tedlanghorst/OpenOBS/hardware/EquipmentList.md

The equipment below is the *minimum* required equipment to construct an OpenOBS. We don't recommend specific brands/items, but the costs represent a cheap but reasonably quality version of each item. Prices were researched for purchase in North Carolina, USA, and may vary based on location.

| Item | Cost |
| --- | --- |
| Soldering station | $50 |
| Multimeter | $10 |
| Wire strippers | $5 |
| Flush cutters | $8 |
| 3D printer | $200 |
| Hot glue gun | $10 |
| Pipe cutter | $20 |
| | |
| | |
| | **Total** |
| | $298 |
