tedlanghorst/OpenOBS/documentation/images/interface.PNG

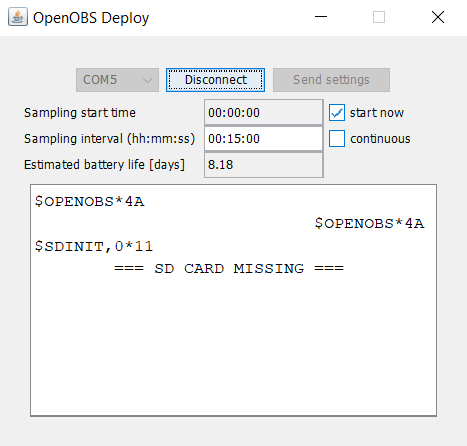
documentation/images/interface.PNG
