tedlanghorst/OpenOBS/hardware/PCB_gerber/schematic_rev2.png

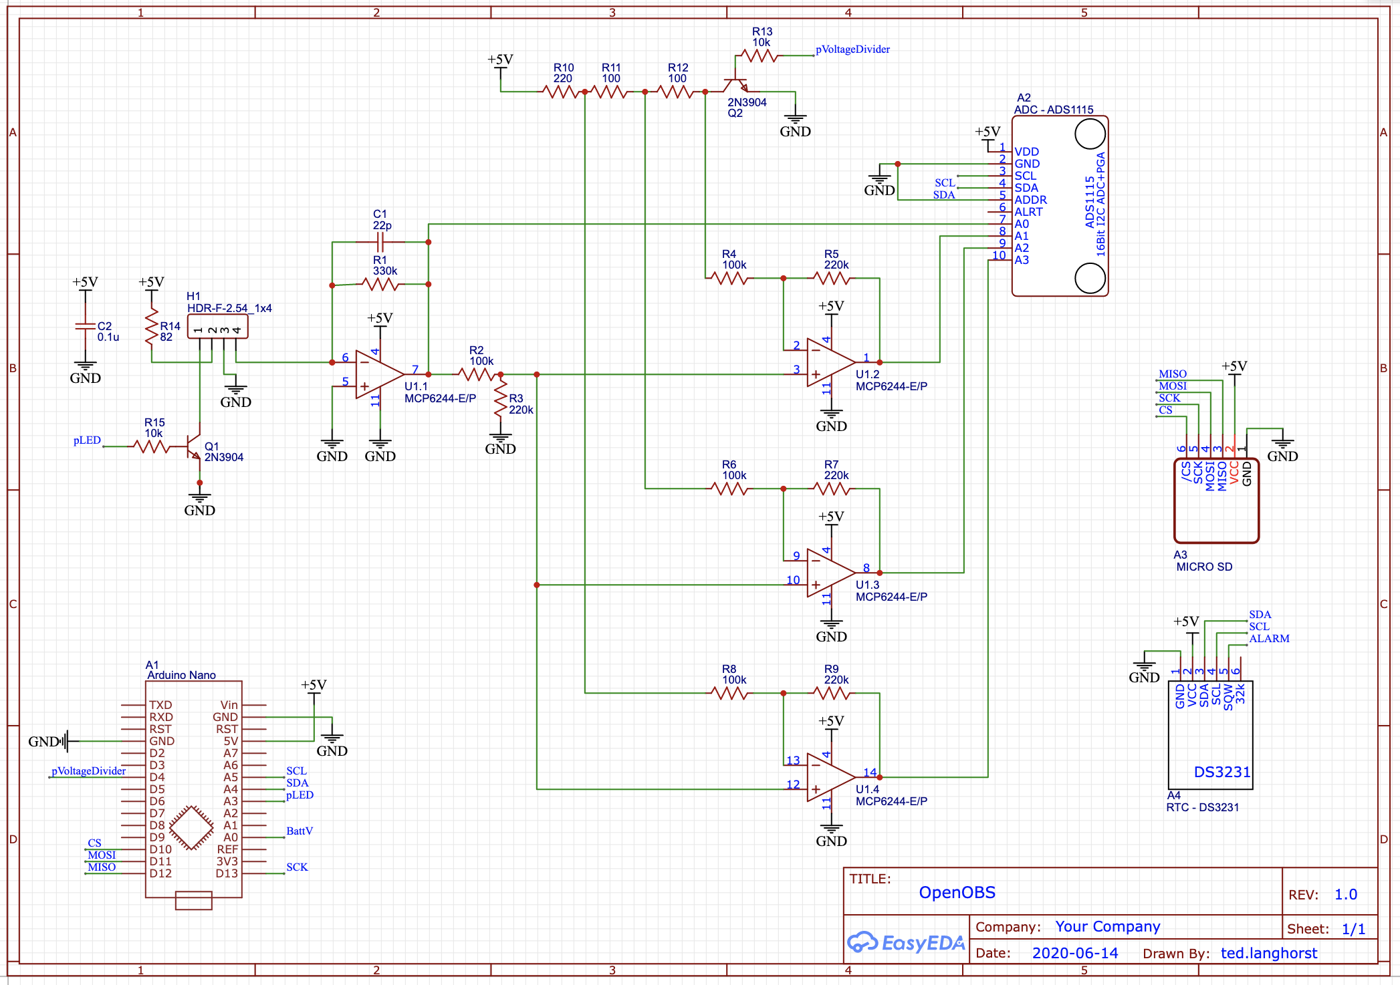
hardware/PCB_gerber/schematic_rev2.png
