tedlanghorst/OpenOBS/hardware/PartsList.md

| Part | Specific Part ID | Unit Cost | Quantity | Total Cost |
| --- | --- | --- | --- | --- |
| Arduino Nano | ATmega328P | $4.50 | 1 | $4.50 |
| ADC module | ADS1115 | $4.00 | 1 | $4.00 |
| microSD card module | | $1.90 | 1 | $1.90 |
| microSD card | | $7.00 | 1 | $7.00 |
| RTC module | DS3231 | $2.20 | 1 | $2.20 |
| RTC coin battery | CR2032 | | 1 | |
| Battery clip | | $1.50 | 1 | $1.50 |
| AA Battery | Any 1.2-1.6V nominal AA battery. | | 2 | |
| NIR emitting diode | VSMF4720-GS08 | $0.82 | 1 | $0.82 |
| NIR emitting diode alternative| SIR67-21C/TR8 | 0.64 | 1 | 0.64 |
| NIR photodiode | SFH 235 FA | $1.34 | 1 | $1.34 |
| Op amp | MCP6244 | $0.63 | 1 | $0.63 |
| MOSFET battery switch | SI2329DS-T1-GE3 | $0.62 | 1 | $0.62 |
| MOSFET battery switch alternative| SSSM3J56MFV,L3F | $0.47 | 1 | $0.47 |
| 0.1  μF capacitor | generic ceramic disc | $0.24 | 1 | $0.24 |
| 22 pF capacitor | generic cermaic disc | $0.24 | 1 | $0.24 |
| NPN transistor | 2n3904 | $0.05 | 2 | $0.10 |
| protoboard | generic 0.1" pitch | $0.20 | 1 | $0.20 |
| Printed circuit board (PCB) | [custom](/hardware/PCB_gerber) | $1.05 | 1 | $1.05 |
| Copper wire | generic 24 gauge | $0.50 | | |
| Solder | | $0.20 | | |
| Hot glue | | $0.20 | | |
| 82 Ω resistor | **1/2 W** or greater | $0.05 | 1 | $0.05 |
| 100 Ω resistor | | $0.05 | 2 | $0.10 |
| 220 Ω resistor | | $0.05 | 1 | $0.05 |
| 10k Ω resistor | | $0.05 | 2 | $0.10 |
| 100k Ω resistor | | $0.05 | 4 | $0.20 |
| 220k Ω resistor | | $0.05 | 4 | $0.20 |
| 330k Ω resistor | | $0.05 | 1 | $0.05 |
| 1 1/2" PVC pipe | Schedule 40 | $1.30 | 8.5" length | $1.30 |
| Compression plug | Wing nut expansion plug for 1 1/2" pipe | $6.10 | 1 | $6.10 |
| Sensor end cap | [3D printed](/hardware/3d_printed_caps) | | 1 | |
| Epoxy | Vivid Scientific hard optically clear water-based epoxy | $0.80 | | $0.80 |

The unit costs of some materials change when purchased in bulk (e.g. resistors and diodes), and others have minimum quantities that will make multiple sensors (e.g. epoxy, solder, PVC pipe). These unit costs were calculated based on purchasing materials for 50 sensors. The cost to build 1 sensor with no starting equipment will be much higher.
