tedlanghorst/OpenOBS/hardware/3d_printed_caps/sensor_housing_39.2mm_v3.stl

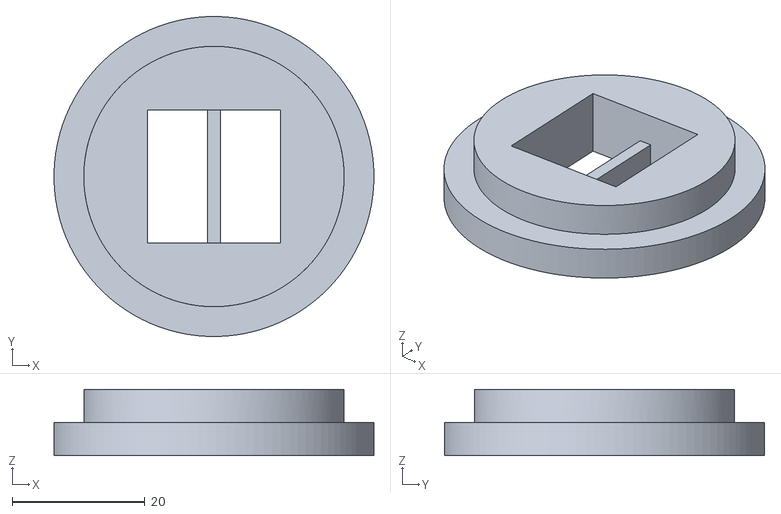
[picture p16: CAD file, 2021-05-03]
hardware/3d_printed_caps/sensor_housing_39.2mm_v3.stl
48.2 x 48.3 x 10.0
