tedlanghorst/OpenOBS/documentation/images/assembled_endcap.png

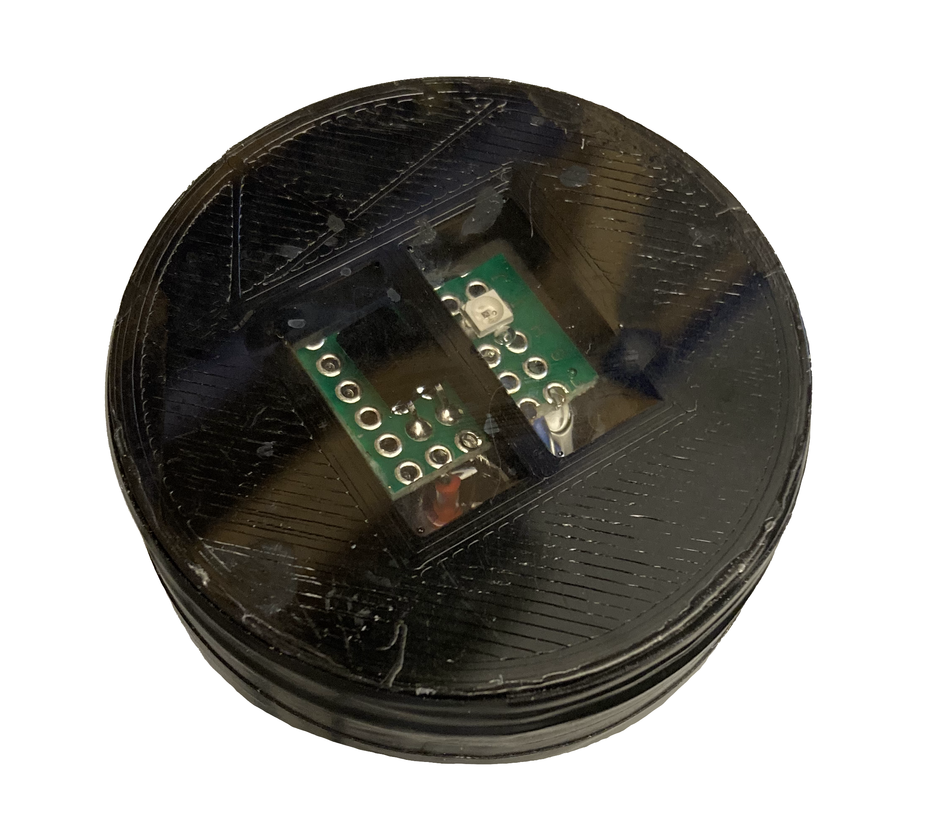
documentation/images/assembled_endcap.png
