tedlanghorst/OpenOBS/hardware/3d_printed_caps/model_endcap.png

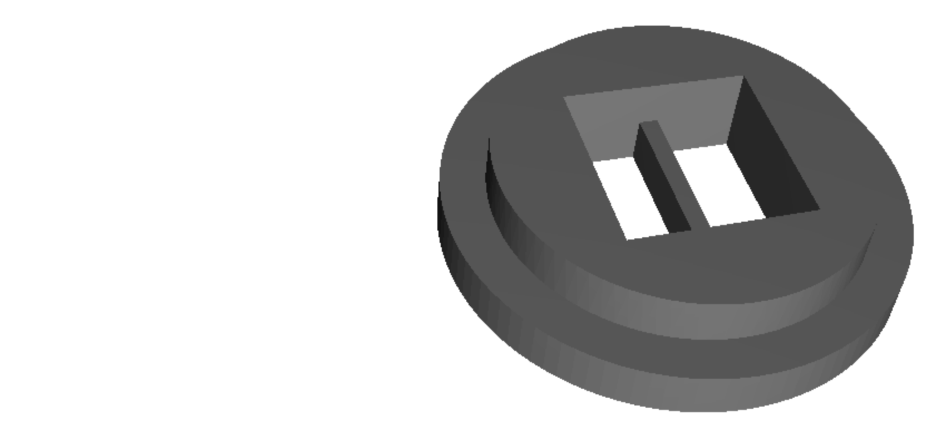
hardware/3d_printed_caps/model_endcap.png
