tedlanghorst/OpenOBS/(threads)

Thread 7 (2021-11-19):

Remove SQW trace from PCB

tedlanghorst, 2021-11-19:
With the new battery scheme, the RTC interrupt now connects to the mosfet before the boost module. Leaving this trace intact will partially back-power the arduino from the RTC coin cell battery during sleep. Currently, we physically cut this track on the PCB, but future revisions should remove it from the design.

tedlanghorst, 2022-03-09:
Fixed in Rev2

Closed 2022-03-09.

Thread 18 (2021-12-22):

Probably want to add the SparkFun driver link

anardek, 2021-12-22:
Hi All, my Dutch colleagues followed your instructions in the GitHub for using the GUI but were having problems connecting to the device. I went back through my emails and realized they hadn't installed the SparkFun driver. Probably want to add that link somewhere to the README

Thread 22 (2022-06-16):

VSMF4720-GS08 - obsolete

mewilliams, 2022-06-16:
I'm looking for parts to construct an OpenOBS. Digikey and Mouser both have show the NIR emiting diode listed in your parts list (VSMF4720-GS08) as obsolete and unavailable. Can you recommend a different sensor?  Thanks!

tedlanghorst, 2022-07-18:
Sorry- just now saw this after your email! I've added alternative parts for both the NIR emitter and power MOSFET.

Closed 2022-07-18.
