tedlanghorst/OpenOBS/arduino_code/sensor_firmware/utils.ino

//Check if the daily file exists already. If not, create one and write headers.
void updateFilename(){
  DateTime now = rtc.now();
  snprintf(filename, 13, "%04u%02u%02u.TXT", now.year(), now.month(), now.date());

  SdFile::dateTimeCallback(dateTime_callback);
  //if we create a new file with this name, set header
  if (file.open(filename, O_CREAT | O_EXCL | O_WRITE)) {
    
    snprintf(messageBuffer, 11, "%04u/%02u/%02u", uploadDT.year(), uploadDT.month(), uploadDT.date());
    
    file.println((__FlashStringHelper*)contactInfo);
    file.print(F("Firmware updated: "));
    file.println(messageBuffer);
    file.print("OpenOBS SN:");
    file.println(serialNumber);
    file.println();
    file.println((__FlashStringHelper*)dataColumnLabels);
    }
}


//callback for SD file creation date.
void dateTime_callback(uint16_t* date, uint16_t* time) {
  DateTime now = rtc.now();
  // return date using FAT_DATE macro to format fields
  *date = FAT_DATE(now.year(), now.month(), now.date());
  // return time using FAT_TIME macro to format fields
  *time = FAT_TIME(now.hour(), now.minute(), now.second());
}

//enable alarm on battery power. Normally disabled
void setBBSQW(){
  uint8_t ctReg = rtc.readRegister(DS3231_CONTROL_REG);
  ctReg |= 0b01000000;
  rtc.writeRegister(DS3231_CONTROL_REG,ctReg); 
}
