tedlanghorst/OpenOBS/(commit log)

2021-05-03 public squash
    [sensor_housing_39.2mm_v3.stl]
2021-05-04 update GUI and fix SD format
    [sensor_firmware.ino, utils.ino]
2021-06-19 Updated battery options
2021-06-23 Updated to current ADS1115 library
2021-10-03 ***Changed file formatting***
    Files are now named yyyyMMdd.txt for better name sorting. Added a column to track milliseconds since starting sampling for better high-frequency analysis. Previously, only 1 second precision from the RTC was used.
2021-10-28 Moved sd card delay to not interrupt continuous sampling
2022-03-07 PCB rev2
